kilimnik/lichtstab/pcb/Lichtstab.kicad_pcb

## KiCad design pcb/Lichtstab.kicad_pcb (2024-06-26)

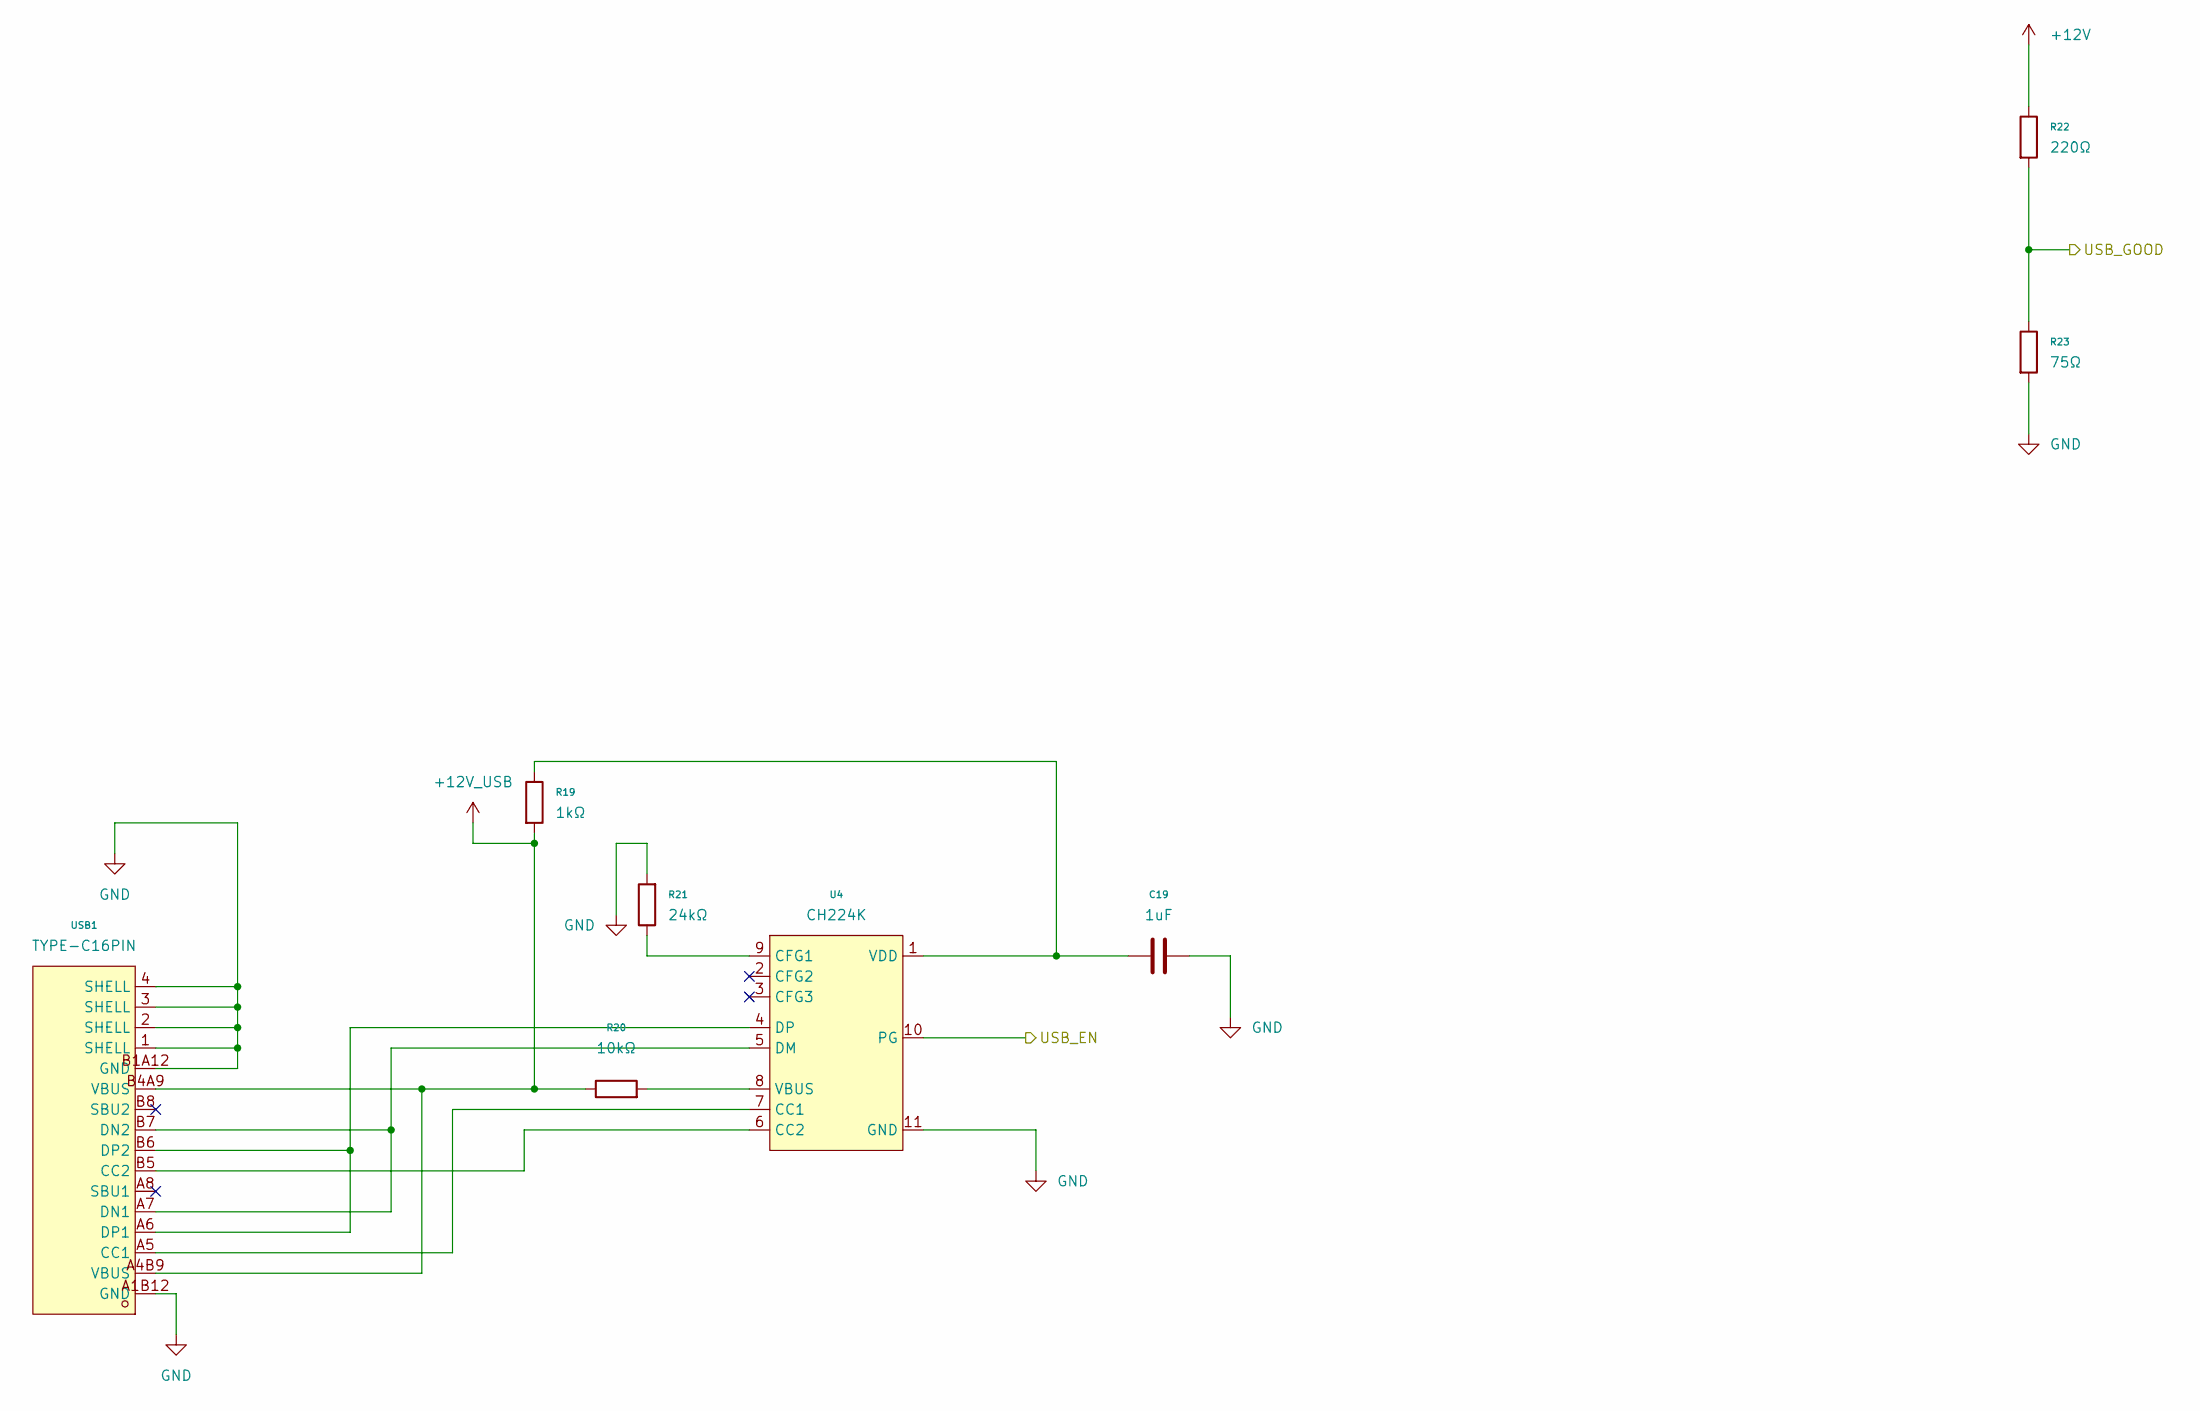
[picture p1: schematic 3_USB-PD.kicad_sch]

Parts:
C19: 1uF; C_0805_2012Metric; LCSC C28323
R19: 1kΩ; R_0603_1608Metric; LCSC C21190
R20: 10kΩ; R_0603_1608Metric; LCSC C25804
R21: 24kΩ; R_0603_1608Metric; LCSC C23352
R22: 220Ω; R_0603_1608Metric; LCSC C22962
R23: 75Ω; R_0603_1608Metric; LCSC C4275
U4: CH224K; ESSOP-10_L4.9-W3.9-P1.0-LS6.0-TL-EP; LCSC C970725
USB1: TYPE-C16PIN; USB-C-SMD_TYPE-C16PIN; LCSC C393939

Connections:
+12V: R22.1; also elsewhere on the board
+12V_USB: R19.2, R20.1, USB1.A4B9 (VBUS), USB1.B4A9 (VBUS); also elsewhere on the board
/General/ESP_EN: U4.10 (PG); also elsewhere on the board
/General/USB_GOOD: R22.2, R23.1; also elsewhere on the board
GND: C19.1, R21.2, R23.2, U4.11 (GND), USB1.1 (SHELL), USB1.2 (SHELL), USB1.3 (SHELL), USB1.4 (SHELL), USB1.A1B12 (GND), USB1.B1A12 (GND); also elsewhere on the board
unnamed: U4.7 (CC1), USB1.A5 (CC1)
unnamed: U4.6 (CC2), USB1.B5 (CC2)
unnamed: R21.1, U4.9 (CFG1)
unnamed: U4.5 (DM), USB1.A7 (DN1), USB1.B7 (DN2)
unnamed: U4.4 (DP), USB1.A6 (DP1), USB1.B6 (DP2)
unnamed: R20.2, U4.8 (VBUS)
unnamed: C19.2, R19.1, U4.1 (VDD)

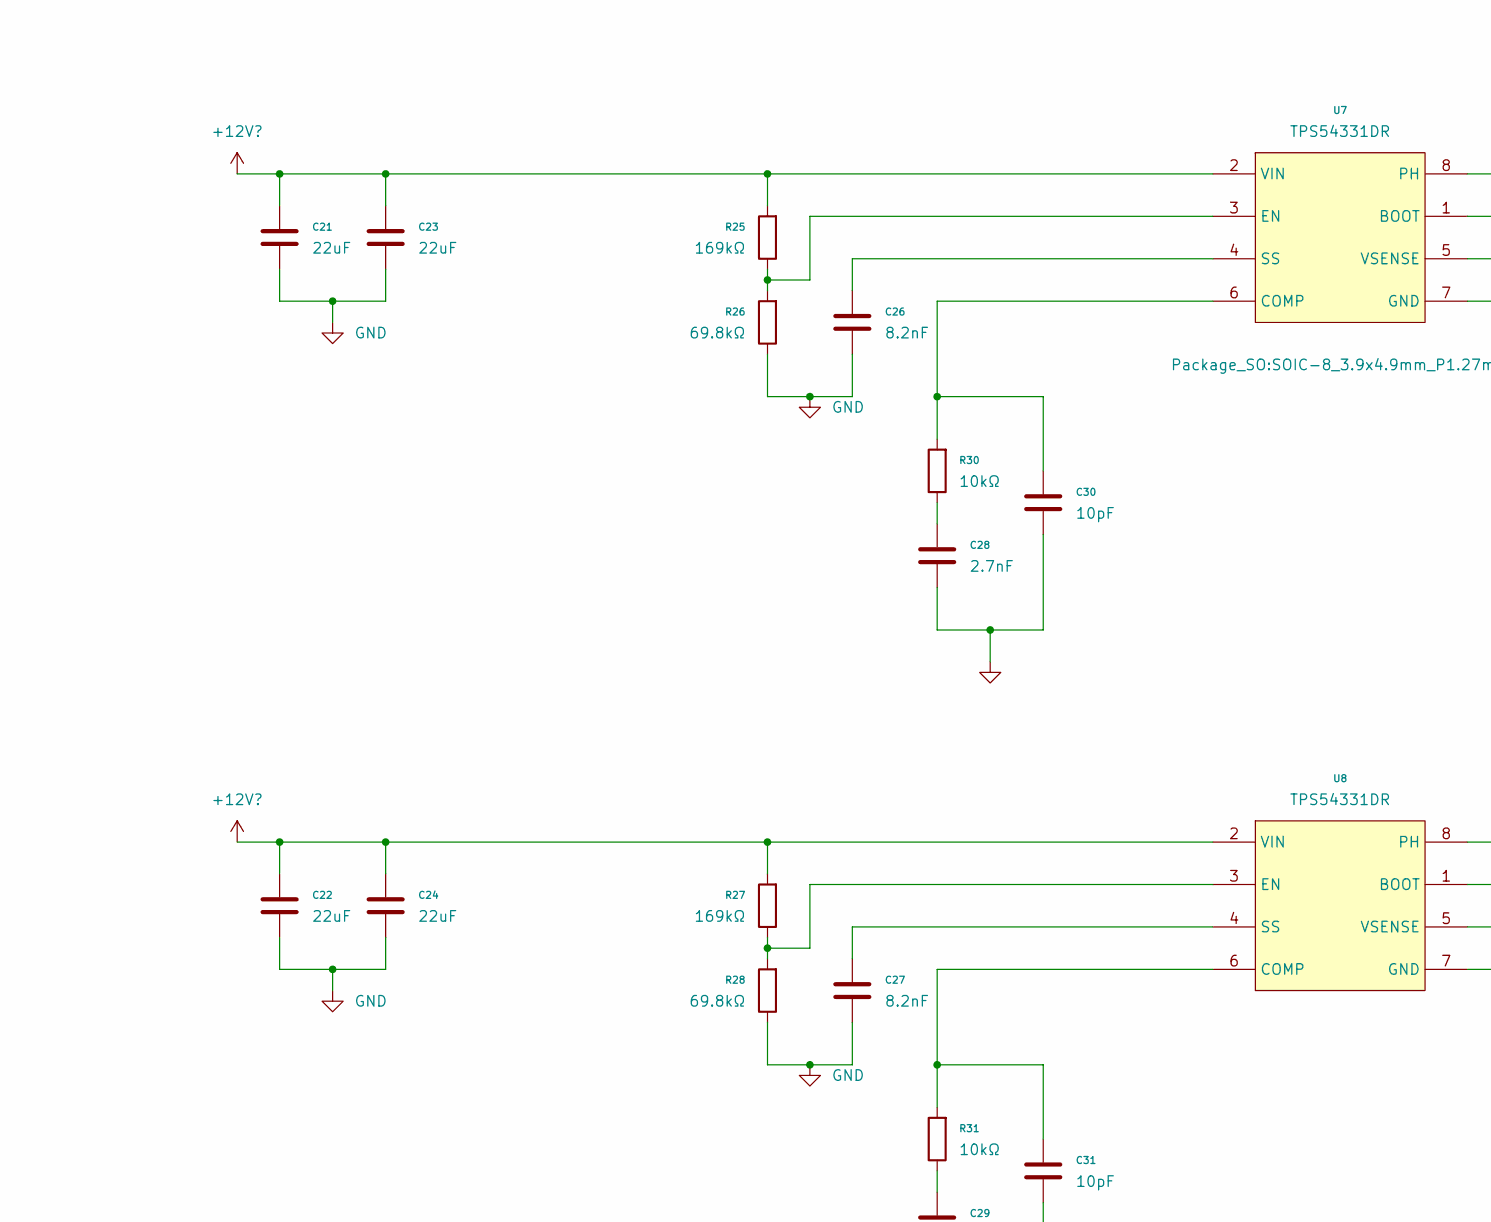
[picture p2: schematic 4_POWER.kicad_sch, part in row 1, column 1]

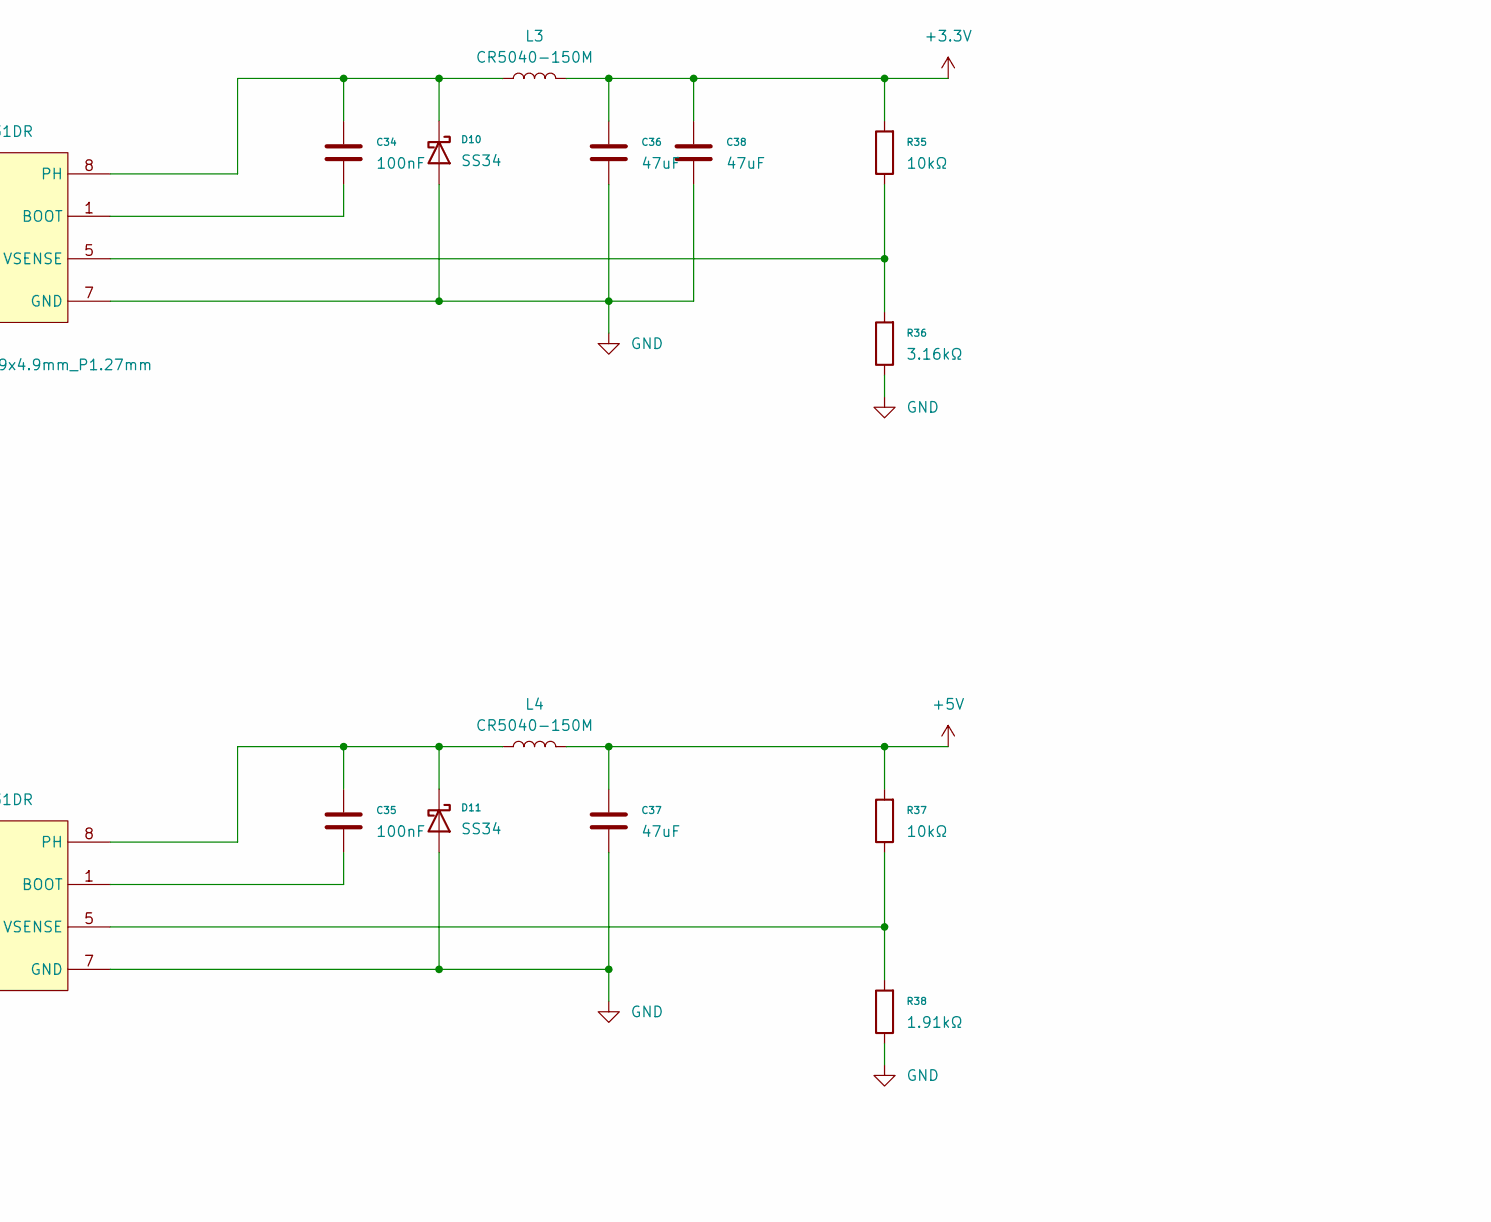
[picture p3: schematic 4_POWER.kicad_sch, part in row 1, column 2]

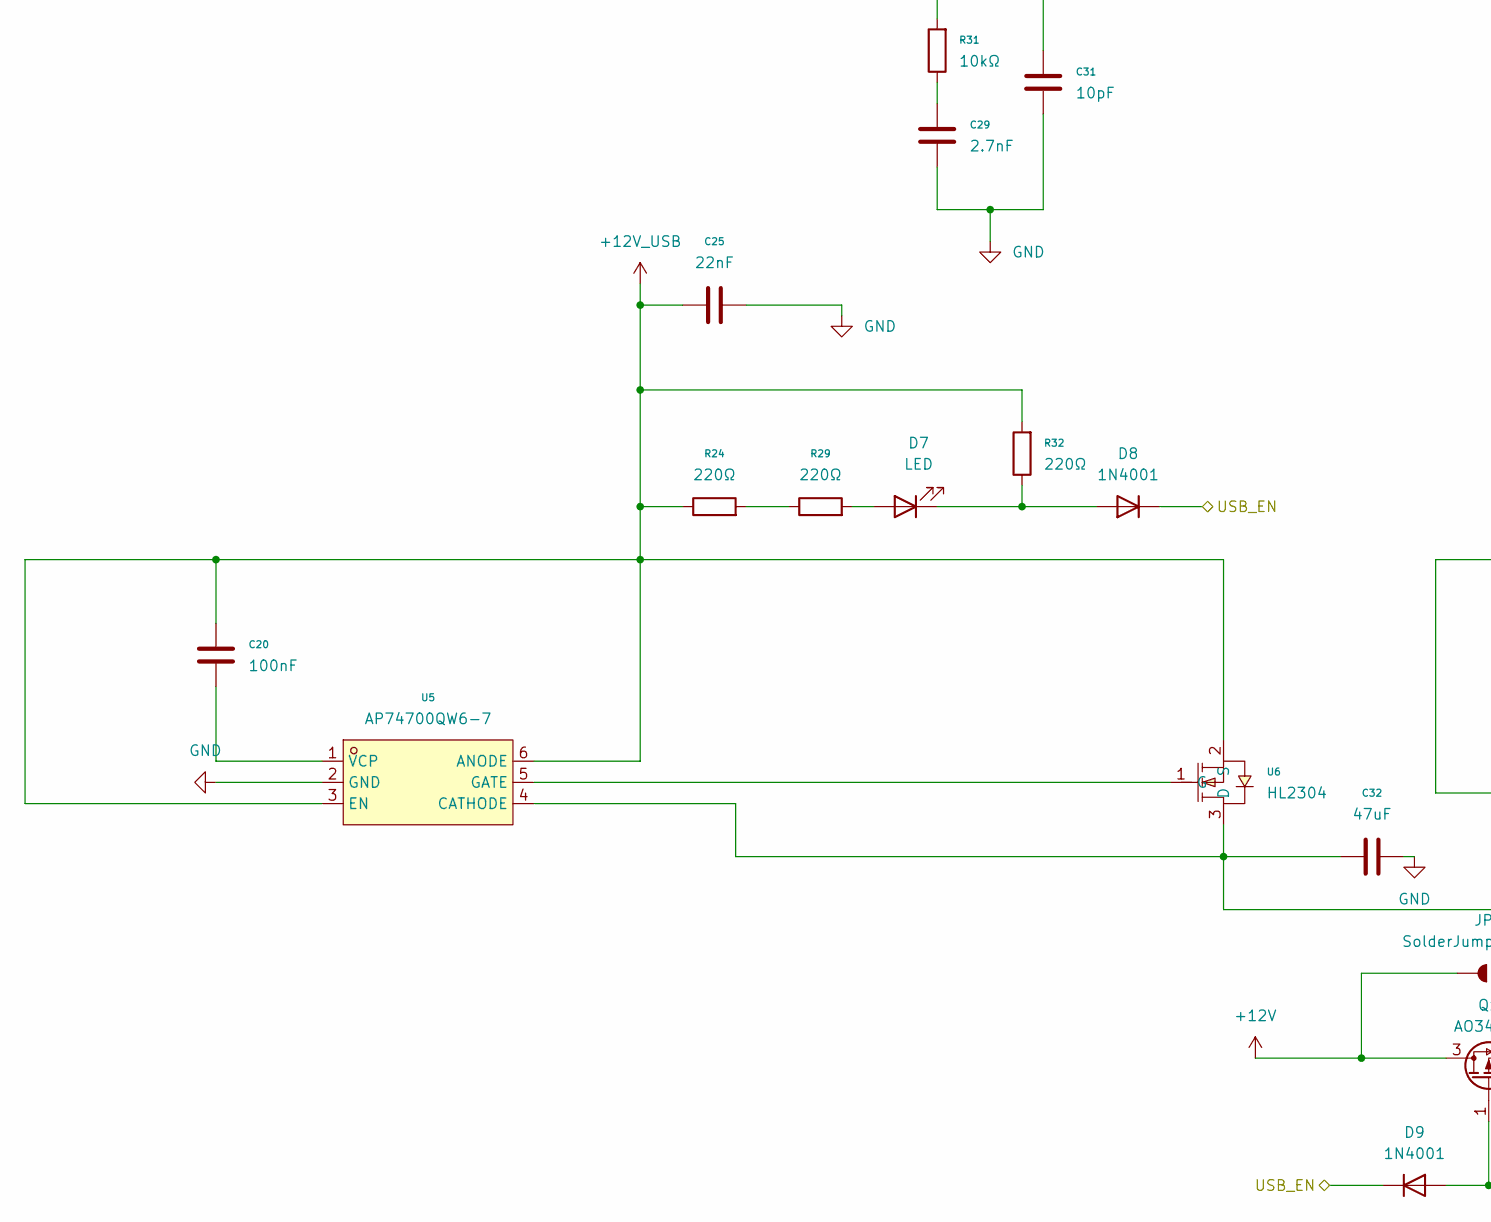
[picture p4: schematic 4_POWER.kicad_sch, part in row 2, column 1]

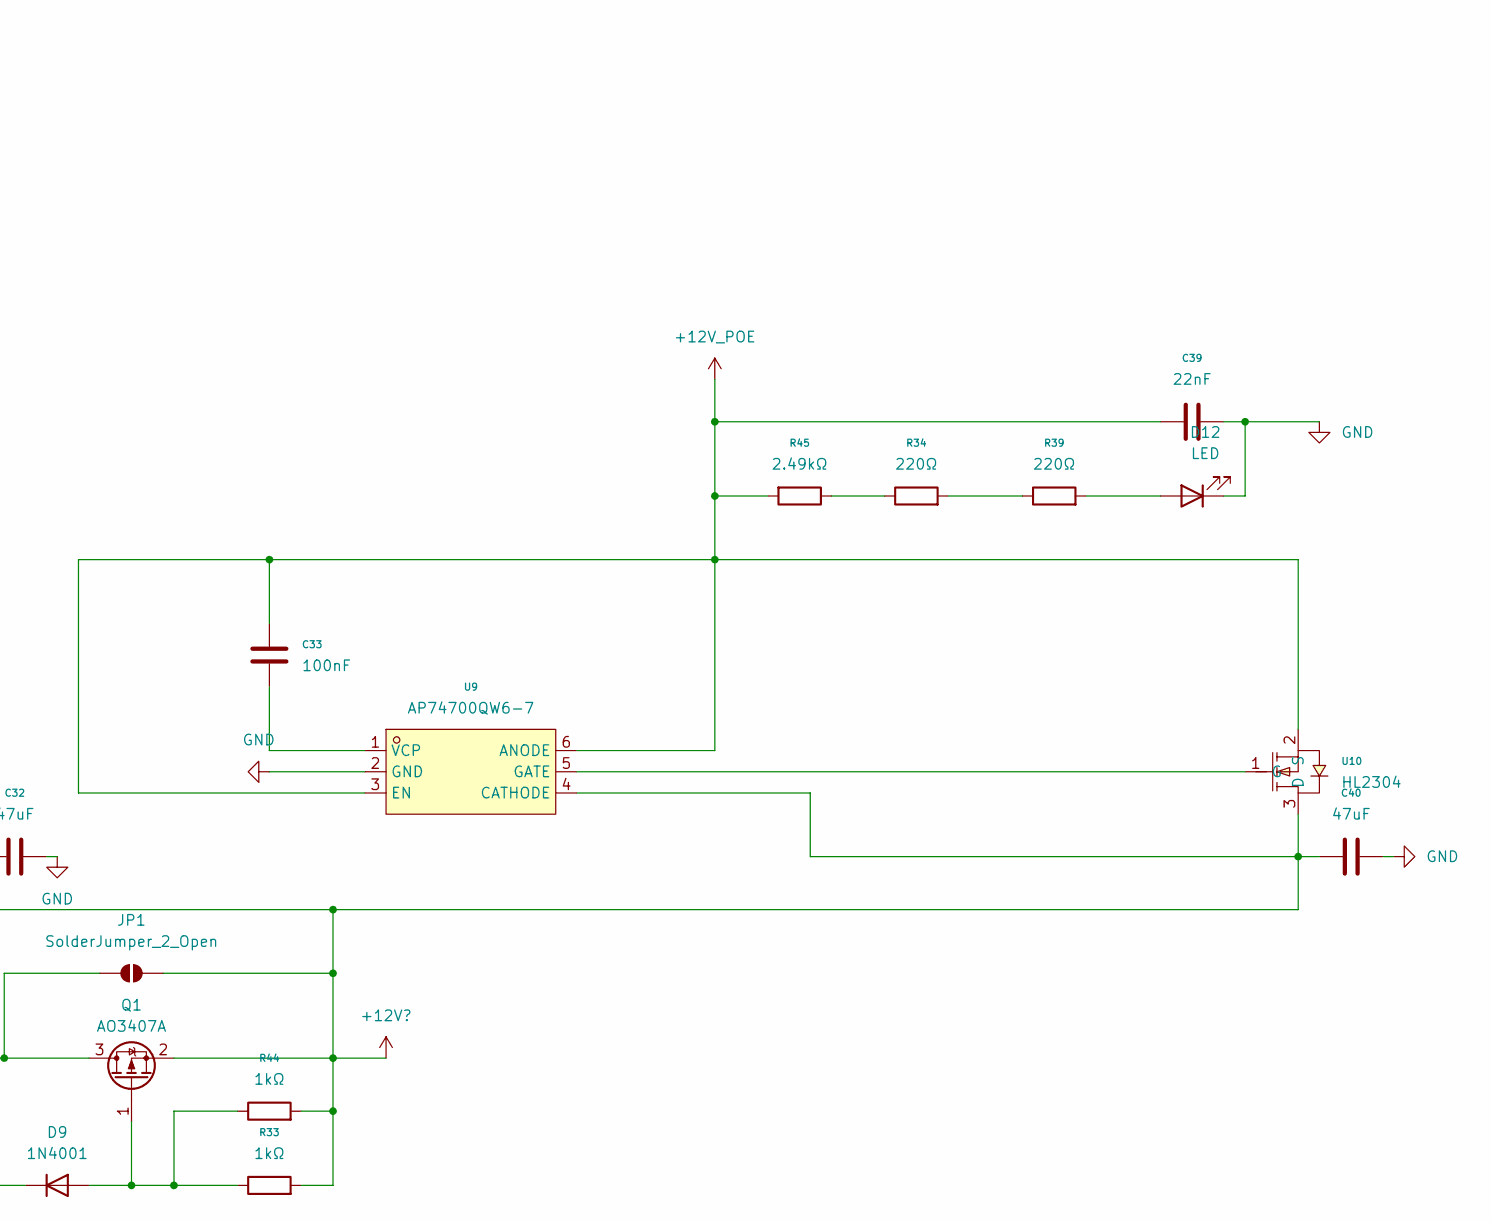
[picture p5: schematic 4_POWER.kicad_sch, part in row 2, column 2]

Parts:
C20, C33, C34, C35: 100nF; C_0603_1608Metric; LCSC C14663
C21, C22, C23, C24: 22uF; C_1210_3225Metric; LCSC C2918506
C25, C39: 22nF; C_0603_1608Metric; LCSC C21122
C26, C27: 8.2nF; C_0603_1608Metric; LCSC C1322360
C28, C29: 2.7nF; C_0805_2012Metric; LCSC C5186791
C30, C31: 10pF; C_0805_2012Metric; LCSC C157608
C32, C36, C37, C38, C40: 47uF; C_1206_3216Metric; LCSC C22367835
D7, D12: LED; LED_0805_2012Metric; LCSC C2297
D8, D9: 1N4001; D_SOD-123F; LCSC C2892326
D10, D11: SS34; D_SMA; LCSC C8678
JP1: SolderJumper_2_Open; SolderJumper-2_P1.3mm_Open_TrianglePad1.0x1.5mm
L3, L4: CR5040-150M; IND-SMD_L5.0-W5.0_SWPA5040S; LCSC Part C520353
Q1: AO3407A; SOT-23; LCSC C347478
R24, R29, R32, R34, R39: 220Ω; R_0603_1608Metric; LCSC C22962
R25, R27: 169kΩ; R_0603_1608Metric; LCSC C22817
R26, R28: 69.8kΩ; R_0603_1608Metric; LCSC C23098
R30, R31, R35, R37: 10kΩ; R_0603_1608Metric; LCSC C25804
R33, R44: 1kΩ; R_0603_1608Metric; LCSC C21190
R36: 3.16kΩ; R_0603_1608Metric; LCSC C22993
R38: 1.91kΩ; R_0603_1608Metric; LCSC C22853
R45: 2.49kΩ; R_0603_1608Metric; LCSC C22908
U5, U9: AP74700QW6-7; SOT-23-6; LCSC C5381661
U6, U10: HL2304; SOT-23; LCSC C7420346
U7, U8: TPS54331DR; SOIC-8_3.9x4.9mm_P1.27mm; LCSC C9865

Connections:
+3.3V: C36.1, C38.1, L3.2, R35.2; also elsewhere on the board
+5V: C37.2, L4.2, R37.2; also elsewhere on the board
+12V: JP1.1 (A), Q1.3 (D); also elsewhere on the board
+12V?: C21.2, C22.2, C23.2, C24.2, C32.1, C40.1, JP1.2 (B), Q1.2 (S), R25.2, R27.2, R33.2, R44.2, U5.4 (CATHODE), U6.3 (D), U7.2 (VIN), U8.2 (VIN), U9.4 (CATHODE), U10.3 (D)
+12V_POE: C33.1, C39.1, R45.2, U9.3 (EN), U9.6 (ANODE), U10.2 (S); also elsewhere on the board
+12V_USB: C20.1, C25.1, R24.1, R32.2, U5.3 (EN), U5.6 (ANODE), U6.2 (S); also elsewhere on the board
/General/ESP_EN: D8.1 (K), D9.1 (K); also elsewhere on the board
GND: C21.1, C22.1, C23.1, C24.1, C25.2, C26.1, C27.1, C28.1, C29.1, C30.1, C31.1, C32.2, C36.2, C37.1, C38.2, C39.2, C40.2, D10.2 (A), D11.2 (A), D12.1 (K), R26.1, R28.1, R36.1, R38.1, U5.2 (GND), U7.7 (GND), U8.7 (GND), U9.2 (GND); also elsewhere on the board
unnamed: C28.2, R30.1
unnamed: C29.2, R31.1
unnamed: D7.2 (A), R29.2
unnamed: D7.1 (K), D8.2 (A), R32.1
unnamed: D9.2 (A), Q1.1 (G), R33.1, R44.1
unnamed: C34.1, D10.1 (K), L3.1, U7.8 (PH)
unnamed: C35.1, D11.1 (K), L4.1, U8.8 (PH)
unnamed: D12.2 (A), R39.2
unnamed: R24.2, R29.1
unnamed: R34.1, R45.1
unnamed: R34.2, R39.1
unnamed: U5.5 (GATE), U6.1 (G)
unnamed: C20.2, U5.1 (VCP)
unnamed: C34.2, U7.1 (BOOT)
unnamed: C30.2, R30.2, U7.6 (COMP)
unnamed: R25.1, R26.2, U7.3 (EN)
unnamed: C26.2, U7.4 (SS)
unnamed: R35.1, R36.2, U7.5 (VSENSE)
unnamed: C35.2, U8.1 (BOOT)
unnamed: C31.2, R31.2, U8.6 (COMP)
unnamed: R27.1, R28.2, U8.3 (EN)
unnamed: C27.2, U8.4 (SS)
unnamed: R37.1, R38.2, U8.5 (VSENSE)
unnamed: C33.2, U9.1 (VCP)
unnamed: U9.5 (GATE), U10.1 (G)

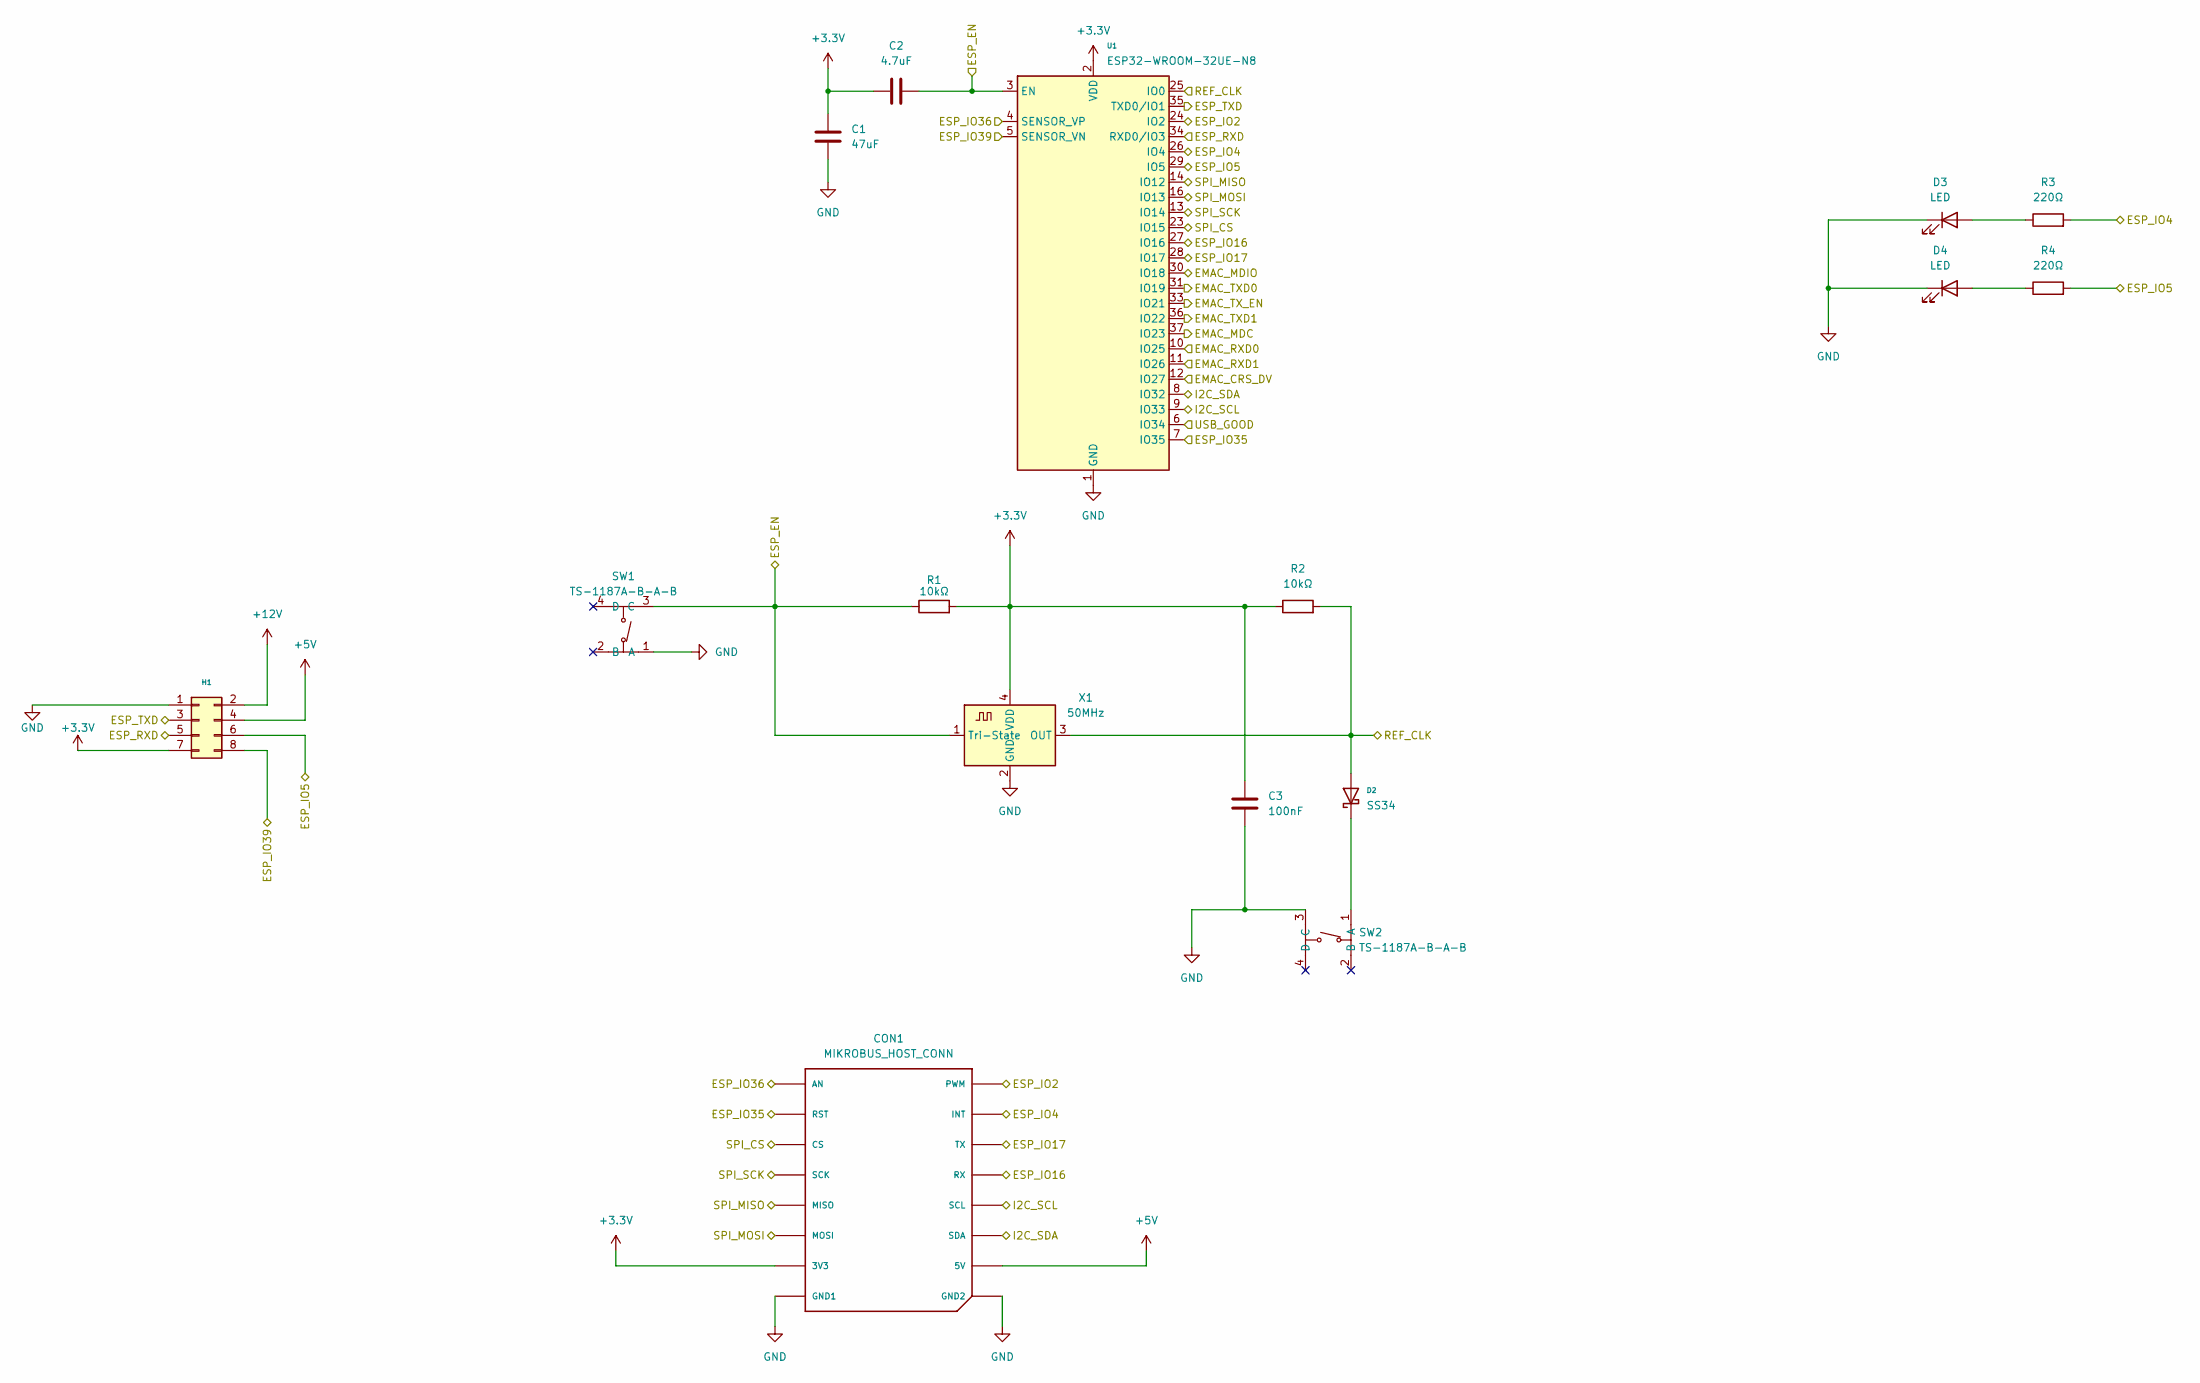
[picture p6: schematic 1_P1.kicad_sch]

Parts:
C1: 47uF; C_1206_3216Metric; LCSC C22367835
C2: 4.7uF; C_0603_1608Metric
C3: 100nF; C_0603_1608Metric
CON1: MIKROBUS_HOST_CONN
D2: SS34; D_SMA; LCSC C8678
D3, D4: LED; LED_0805_2012Metric; LCSC C34499
H1: PinHeader_2x04_P2.54mm_Vertical_SMD; Manufacturer Part Programming Header; LCSC C192300
R1, R2: 10kΩ; R_0603_1608Metric
R3, R4: 220Ω; R_0603_1608Metric
SW1: TS-1187A-B-A-B; SW-SMD_4P-L5.1-W5.1-P3.70-LS6.5-TL-2; Manufacturer Part Reset Switch; LCSC C318884
SW2: TS-1187A-B-A-B; SW-SMD_4P-L5.1-W5.1-P3.70-LS6.5-TL-2; Manufacturer Part Boot Switch; LCSC C318884
U1: ESP32-WROOM-32UE-N8; ESP32-WROOM-32UE; LCSC C701345
X1: 50MHz; Crystal_SMD_3225-4Pin_3.2x2.5mm; LCSC C717684

Connections:
+3.3V: C1.1, C2.2, C3.1, CON1.P7 (3V3), H1.7, R1.2, R2.1, U1.2 (VDD), X1.4 (VDD); also elsewhere on the board
+5V: CON1.P10 (5V), H1.4; also elsewhere on the board
+12V: H1.2; also elsewhere on the board
/General/EMAC_CRS_DV: U1.12 (IO27); also elsewhere on the board
/General/EMAC_MDC: U1.37 (IO23); also elsewhere on the board
/General/EMAC_MDIO: U1.30 (IO18); also elsewhere on the board
/General/EMAC_RXD0: U1.10 (IO25); also elsewhere on the board
/General/EMAC_RXD1: U1.11 (IO26); also elsewhere on the board
/General/EMAC_TXD0: U1.31 (IO19); also elsewhere on the board
/General/EMAC_TXD1: U1.36 (IO22); also elsewhere on the board
/General/EMAC_TX_EN: U1.33 (IO21); also elsewhere on the board
/General/ESP_EN: C2.1, R1.1, SW1.3 (C), U1.3 (EN), X1.1 (Tri-State); also elsewhere on the board
/General/ESP_IO2: CON1.P16 (PWM), U1.24 (IO2); also elsewhere on the board
/General/ESP_IO4: CON1.P15 (INT), R3.2, U1.26 (IO4); also elsewhere on the board
/General/ESP_IO5: H1.6, R4.2, U1.29 (IO5); also elsewhere on the board
/General/ESP_IO16: CON1.P13 (RX), U1.27 (IO16); also elsewhere on the board
/General/ESP_IO17: CON1.P14 (TX), U1.28 (IO17); also elsewhere on the board
/General/ESP_IO35: CON1.P2 (RST), U1.7 (IO35); also elsewhere on the board
/General/ESP_IO36: CON1.P1 (AN), U1.4 (SENSOR_VP); also elsewhere on the board
/General/ESP_IO39: H1.8, U1.5 (SENSOR_VN); also elsewhere on the board
/General/ESP_RXD: H1.5, U1.34 (RXD0/IO3)
/General/ESP_TXD: H1.3, U1.35 (TXD0/IO1)
/General/I2C_SCL: CON1.P12 (SCL), U1.9 (IO33); also elsewhere on the board
/General/I2C_SDA: CON1.P11 (SDA), U1.8 (IO32); also elsewhere on the board
/General/REF_CLK: D2.2 (A), R2.2, U1.25 (IO0), X1.3 (OUT); also elsewhere on the board
/General/SPI_CS: CON1.P3 (CS), U1.23 (IO15); also elsewhere on the board
/General/SPI_MISO: CON1.P5 (MISO), U1.14 (IO12); also elsewhere on the board
/General/SPI_MOSI: CON1.P6 (MOSI), U1.16 (IO13); also elsewhere on the board
/General/SPI_SCK: CON1.P4 (SCK), U1.13 (IO14); also elsewhere on the board
/General/USB_GOOD: U1.6 (IO34); also elsewhere on the board
GND: C1.2, C3.2, CON1.P8 (GND1), CON1.P9 (GND2), D3.1 (K), D4.1 (K), H1.1, SW1.1 (A), SW2.3 (C), U1.1 (GND), U1.15 (GND), U1.38 (GND), U1.39 (GND), X1.2 (GND); also elsewhere on the board
unnamed: D2.1 (K), SW2.1 (A)
unnamed: D3.2 (A), R3.1
unnamed: D4.2 (A), R4.1

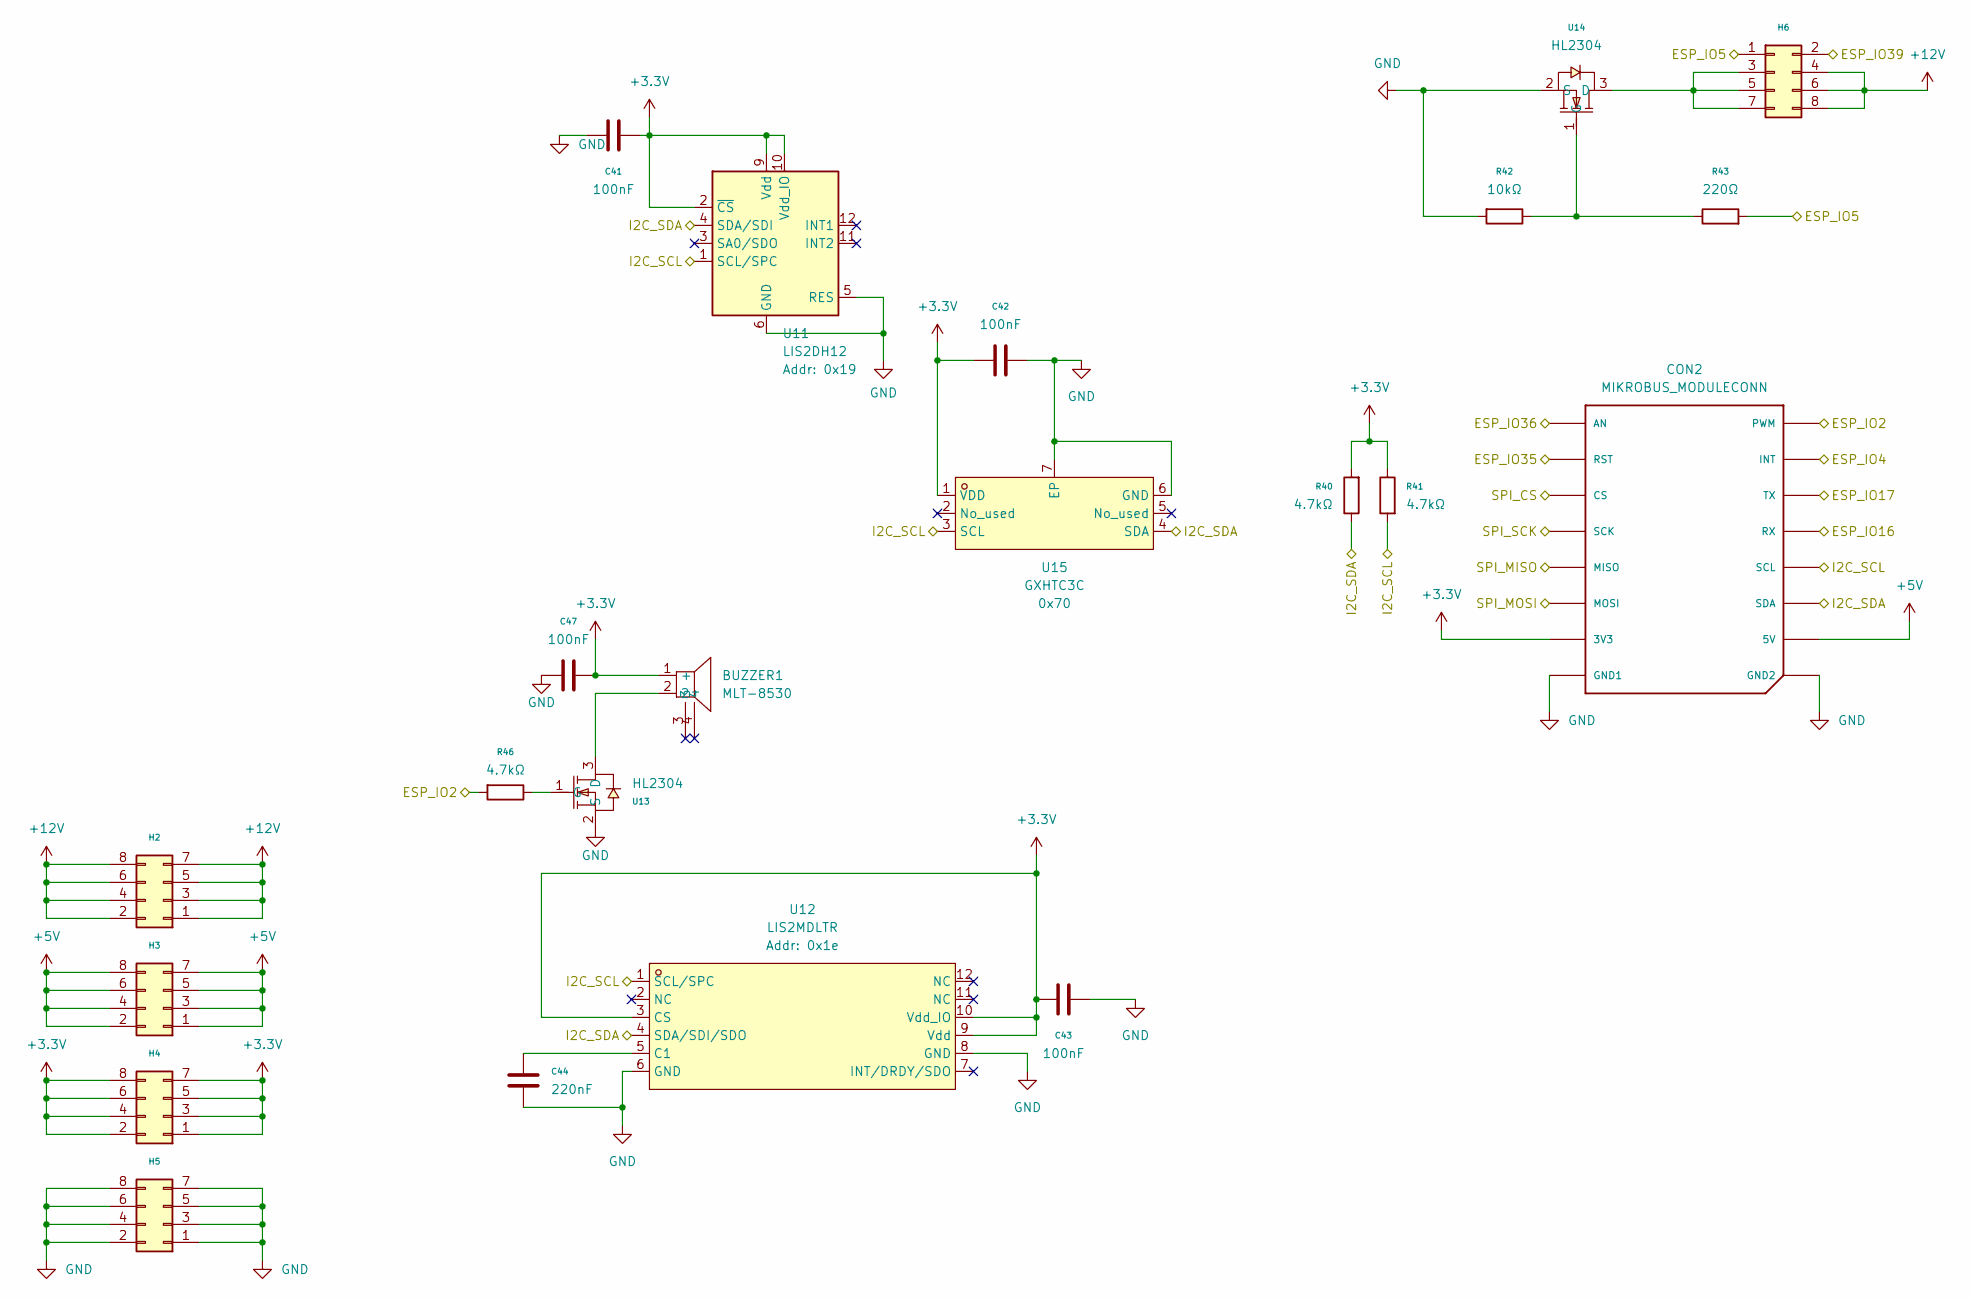
[picture p7: schematic sensors.kicad_sch]

Parts:
BUZZER1: MLT-8530; BUZ-SMD_4P-L8.5-W8.5-P8.50-BR; LCSC Part C94599
C41, C42, C43, C47: 100nF; C_0603_1608Metric; LCSC C14663
C44: 220nF; C_0603_1608Metric
CON2: MIKROBUS_MODULECONN; MIKROBUS_MODULE_CONN
H2: 2.54-2*4P立贴针; PinHeader_2x04_P2.54mm_Vertical_SMD; Manufacturer Part 12V Header; LCSC C192300
H3, H4: 2.54-2*4P立贴针; PinHeader_2x04_P2.54mm_Vertical_SMD; Manufacturer Part 3.3V Header; LCSC C192300
H5: 2.54-2*4P立贴针; PinHeader_2x04_P2.54mm_Vertical_SMD; Manufacturer Part GND Header; LCSC C192300
H6: 2.54-2*4P立贴针; PinHeader_2x04_P2.54mm_Vertical_SMD; Manufacturer Part Light Header; LCSC C192300
R40, R41, R46: 4.7kΩ; R_0603_1608Metric; LCSC C23162
R42: 10kΩ; R_0603_1608Metric; LCSC C25804
R43: 220Ω; R_0603_1608Metric; LCSC C22962
U11: LIS2DH12; LGA-12_2x2mm_P0.5mm; LCSC C110926
U12: LIS2MDLTR; LGA-12_L2.0-W2.0-P0.50-BL; LCSC C919695
U13, U14: HL2304; SOT-23; LCSC C7420346
U15: GXHTC3C; DFN-6_L2.0-W2.0-P0.50-TL-EP; LCSC Part C2913568

Connections:
+3.3V: BUZZER1.1 (+), C41.1, C42.2, C43.1, C47.1, CON2.P7 (3V3), H4.1, H4.2, H4.3, H4.4, H4.5, H4.6, H4.7, H4.8, R40.2, R41.1, U11.2 (~CS), U11.9 (Vdd), U11.10 (Vdd_IO), U12.3 (CS), U12.9 (Vdd), U12.10 (Vdd_IO), U15.1 (VDD); also elsewhere on the board
+5V: CON2.P10 (5V), H3.1, H3.2, H3.3, H3.4, H3.5, H3.6, H3.7, H3.8; also elsewhere on the board
+12V: H2.1, H2.2, H2.3, H2.4, H2.5, H2.6, H2.7, H2.8, H6.4, H6.6, H6.8; also elsewhere on the board
/General/ESP_IO2: CON2.P16 (PWM), R46.2; also elsewhere on the board
/General/ESP_IO4: CON2.P15 (INT); also elsewhere on the board
/General/ESP_IO5: H6.1, R43.2; also elsewhere on the board
/General/ESP_IO16: CON2.P13 (RX); also elsewhere on the board
/General/ESP_IO17: CON2.P14 (TX); also elsewhere on the board
/General/ESP_IO35: CON2.P2 (RST); also elsewhere on the board
/General/ESP_IO36: CON2.P1 (AN); also elsewhere on the board
/General/ESP_IO39: H6.2; also elsewhere on the board
/General/I2C_SCL: CON2.P12 (SCL), R41.2, U11.1 (SCL/SPC), U12.1 (SCL/SPC), U15.3 (SCL); also elsewhere on the board
/General/I2C_SDA: CON2.P11 (SDA), R40.1, U11.4 (SDA/SDI), U12.4 (SDA/SDI/SDO), U15.4 (SDA); also elsewhere on the board
/General/SPI_CS: CON2.P3 (CS); also elsewhere on the board
/General/SPI_MISO: CON2.P5 (MISO); also elsewhere on the board
/General/SPI_MOSI: CON2.P6 (MOSI); also elsewhere on the board
/General/SPI_SCK: CON2.P4 (SCK); also elsewhere on the board
GND: C41.2, C42.1, C43.2, C44.1, C47.2, CON2.P8 (GND1), CON2.P9 (GND2), H5.1, H5.2, H5.3, H5.4, H5.5, H5.6, H5.7, H5.8, R42.2, U11.5 (RES), U11.6 (GND), U11.7 (GND), U11.8 (GND), U12.6 (GND), U12.8 (GND), U13.2 (S), U14.2 (S), U15.6 (GND), U15.7 (EP); also elsewhere on the board
unnamed: H6.3, H6.5, H6.7, U14.3 (D)
unnamed: C44.2, U12.5 (C1)
unnamed: BUZZER1.2, U13.3 (D)
unnamed: R46.1, U13.1 (G)
unnamed: R42.1, R43.1, U14.1 (G)
