kilimnik/lichtstab/pcb/Lichtstab.kicad_pcb

## KiCad design pcb/Lichtstab.kicad_pcb (continued)

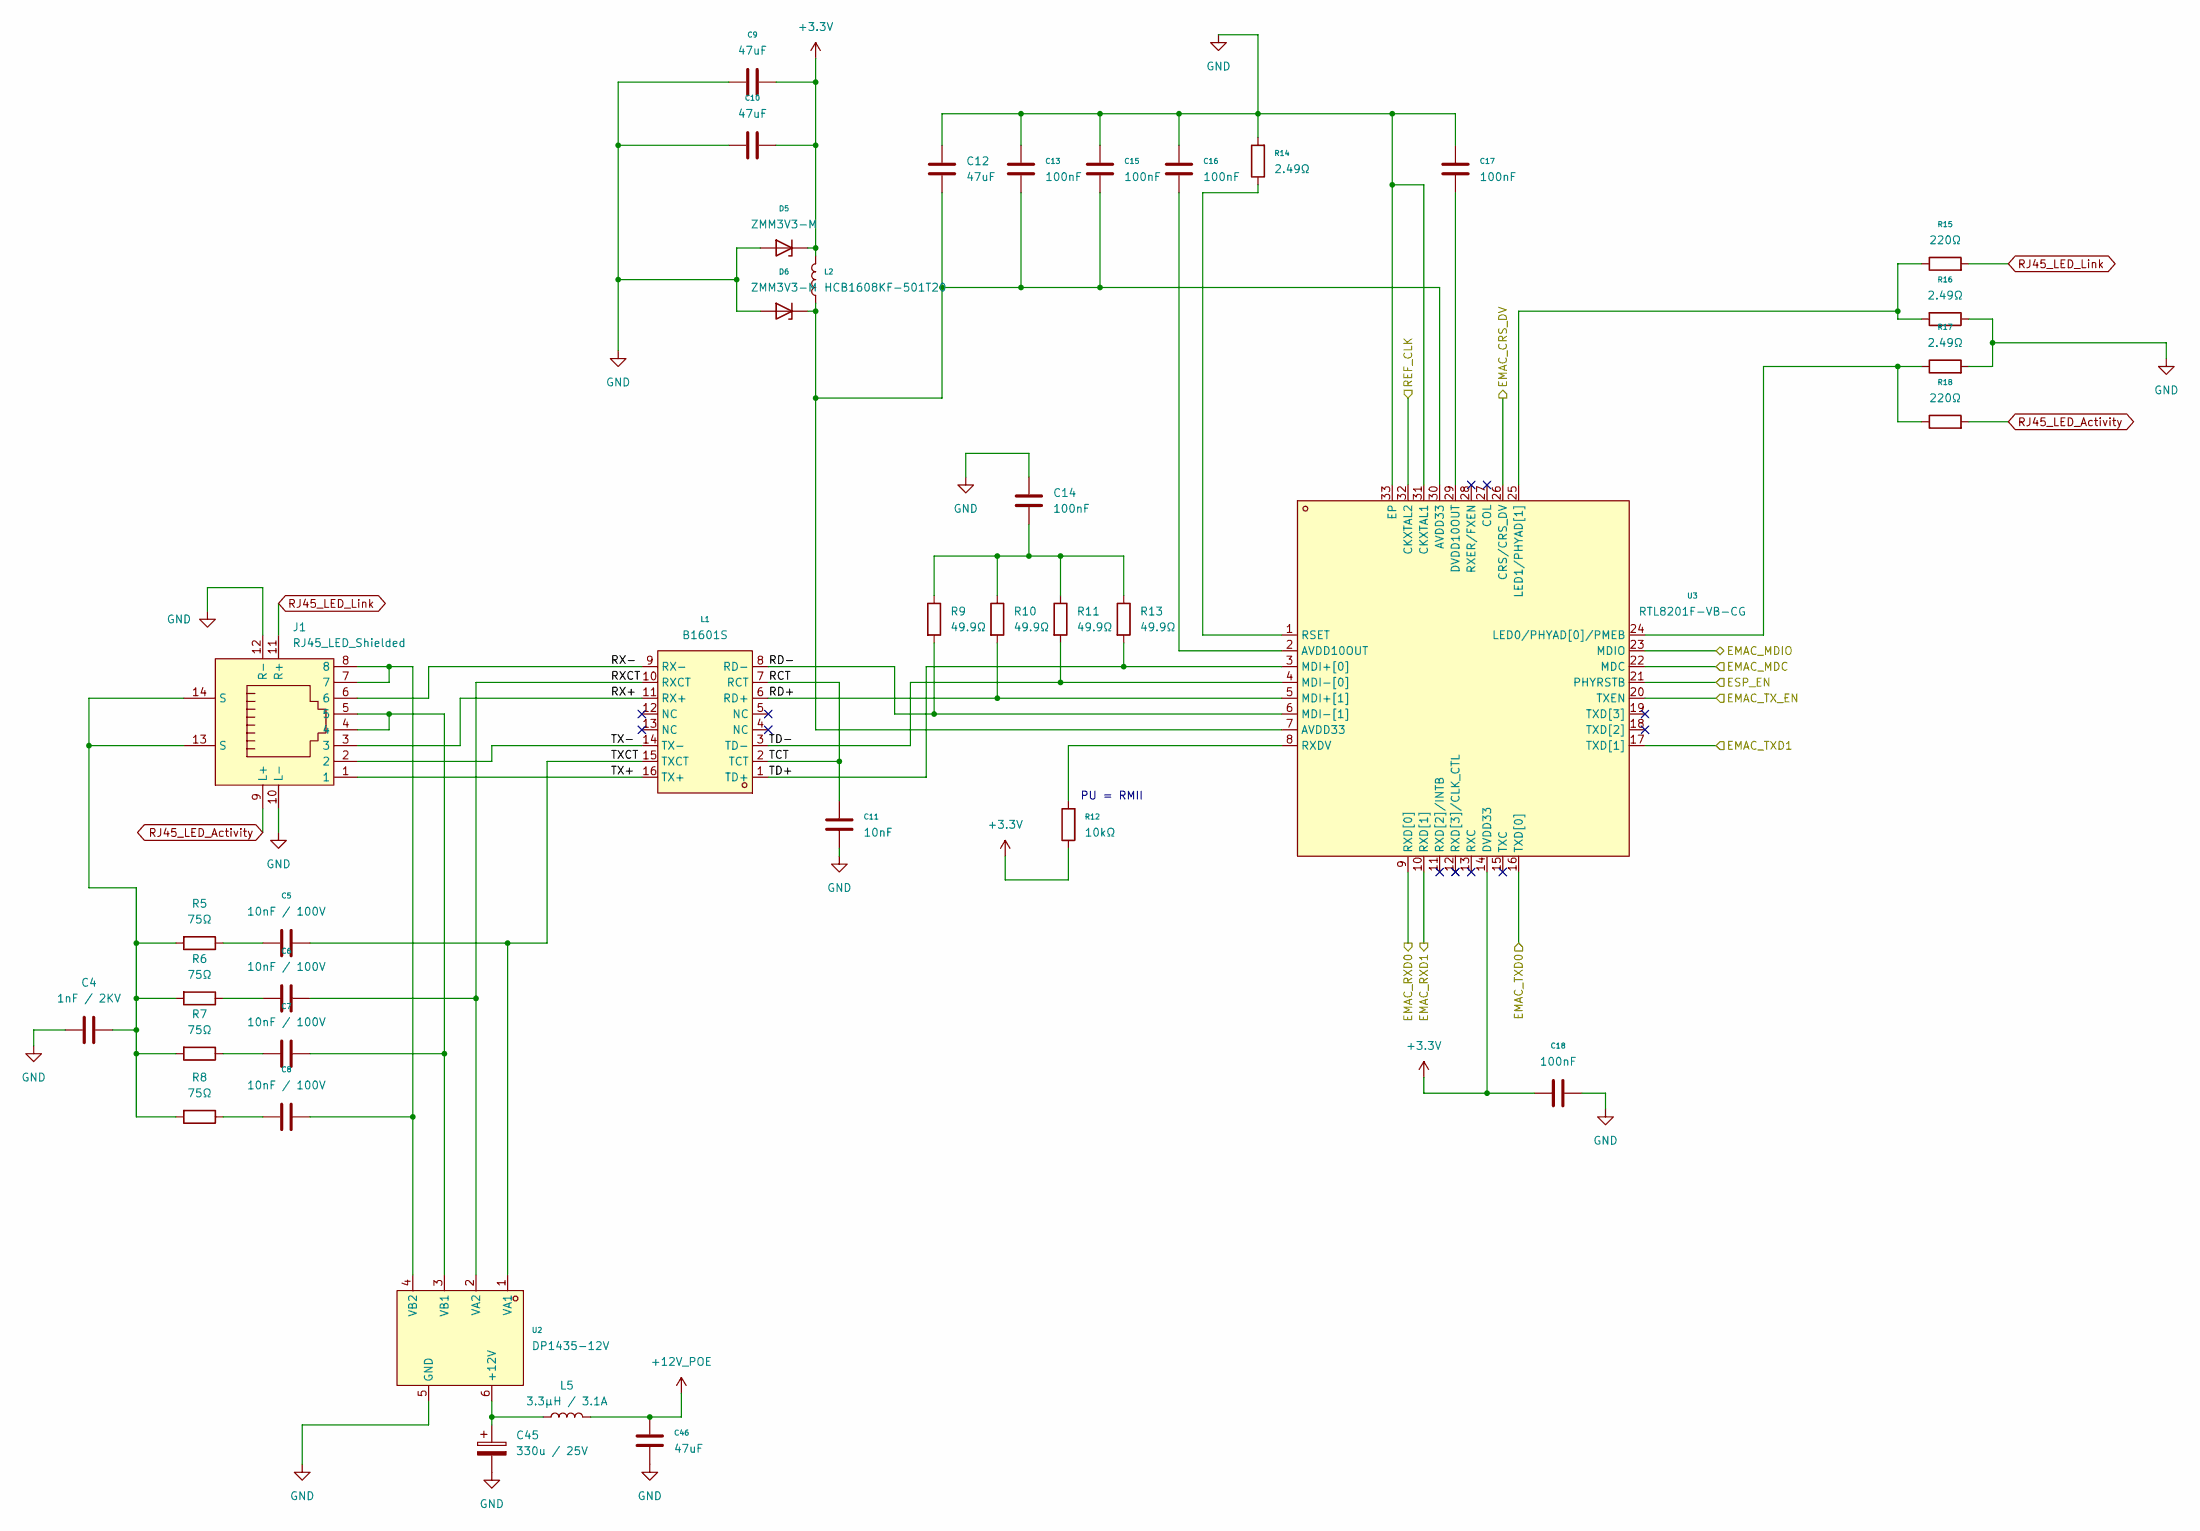
[picture p8: schematic 2_POE.kicad_sch]

Parts:
C4: 1nF / 2KV; C_1206_3216Metric
C5, C6, C7, C8: 10nF / 100V; C_0603_1608Metric; LCSC C43253
C9, C10, C12, C46: 47uF; C_1206_3216Metric; LCSC C22367835
C11: 10nF; C_0603_1608Metric; LCSC C43253
C13, C15, C16, C17, C18: 100nF; C_0603_1608Metric; LCSC C14663
C14: 100nF; C_0603_1608Metric
C45: 330u / 25V; CP_Elec_8x10.5; LCSC C335985
D5, D6: ZMM3V3-M; D_MiniMELF; LCSC C2891740
J1: RJ45_LED_Shielded; RJ45-TH_R-RJ45R08P-C000; LCSC Part C386757
L1: B1601S; SMD-16_L12.7-W7.0-P1.27-LS9.5-BL; LCSC C510548
L2: HCB1608KF-501T20; L_0603_1608Metric; LCSC C356977
L5: 3.3µH / 3.1A; L_Changjiang_FNR5030S; LCSC C2847470
R5, R6, R7, R8: 75Ω; R_0603_1608Metric; LCSC C4275
R9, R10, R11, R13: 49.9Ω; R_0402_1005Metric
R12: 10kΩ; R_0603_1608Metric; LCSC C25804
R14, R16, R17: 2.49Ω; R_0603_1608Metric; LCSC C22908
R15, R18: 220Ω; R_0603_1608Metric; LCSC C22962
U2: DP1435-12V; PWRM-TH_DP1435-XX; LCSC Part C5380098
U3: RTL8201F-VB-CG; TQFN-32-1EP_5x5mm_P0.5mm_EP3.4x3.4mm_ThermalVias; LCSC C45044

Connections:
+3.3V: C9.1, C10.1, C18.1, D5.1 (K), L2.2, R12.1, U3.14 (DVDD33); also elsewhere on the board
+12V_POE: C46.2, L5.2; also elsewhere on the board
/General/EMAC_CRS_DV: U3.26 (CRS/CRS_DV); also elsewhere on the board
/General/EMAC_MDC: U3.22 (MDC); also elsewhere on the board
/General/EMAC_MDIO: U3.23 (MDIO); also elsewhere on the board
/General/EMAC_RXD0: U3.9 (RXD[0]); also elsewhere on the board
/General/EMAC_RXD1: U3.10 (RXD[1]); also elsewhere on the board
/General/EMAC_TXD0: U3.16 (TXD[0]); also elsewhere on the board
/General/EMAC_TXD1: U3.17 (TXD[1]); also elsewhere on the board
/General/EMAC_TX_EN: U3.20 (TXEN); also elsewhere on the board
/General/ESP_EN: U3.21 (PHYRSTB); also elsewhere on the board
/General/REF_CLK: U3.32 (CKXTAL2); also elsewhere on the board
/POE/RCT: C11.2, L1.2 (TCT), L1.7 (RCT)
/POE/RD+: L1.6 (RD+), R10.2, U3.5 (MDI+[1])
/POE/RD-: L1.8 (RD-), R9.2, U3.6 (MDI-[1])
/POE/RX+: J1.3, L1.11 (RX+)
/POE/RX-: J1.6, L1.9 (RX-)
/POE/RXCT: C6.2, L1.10 (RXCT), U2.2 (VA2)
/POE/TD+: L1.1 (TD+), R13.2, U3.3 (MDI+[0])
/POE/TD-: L1.3 (TD-), R11.2, U3.4 (MDI-[0])
/POE/TX+: J1.1, L1.16 (TX+)
/POE/TX-: J1.2, L1.14 (TX-)
/POE/TXCT: C5.2, L1.15 (TXCT), U2.1 (VA1)
GND: C4.1, C9.2, C10.2, C11.1, C12.1, C13.1, C14.1, C15.1, C16.1, C17.1, C18.2, C45.2, C46.1, D5.2 (A), D6.2 (A), J1.10 (L-), J1.12 (R-), R14.2, R16.1, R17.2, U2.5 (GND), U3.31 (CKXTAL1), U3.33 (EP); also elsewhere on the board
unnamed: C4.2, J1.13 (S), J1.14 (S), R5.2, R6.2, R7.2, R8.2
unnamed: C5.1, R5.1
unnamed: C6.1, R6.1
unnamed: C7.1, R7.1
unnamed: C8.2, R8.1
unnamed: C14.2, R9.1, R10.1, R11.1, R13.1
unnamed: C12.2, C13.2, C15.2, D6.1 (K), L2.1, U3.7 (AVDD33), U3.30 (AVDD33)
unnamed: C45.1, L5.1, U2.6 (+12V)
unnamed: C7.2, J1.4, J1.5, U2.3 (VB1)
unnamed: C8.1, J1.7, J1.8, U2.4 (VB2)
unnamed: C16.2, U3.2 (AVDD10OUT)
unnamed: C17.2, U3.29 (DVDD10OUT)
unnamed: R17.1, R18.1, U3.24 (LED0/PHYAD[0]/PMEB)
unnamed: R15.1, R16.2, U3.25 (LED1/PHYAD[1])
unnamed: R14.1, U3.1 (RSET)
unnamed: R12.2, U3.8 (RXDV)
RJ45_LED_Activity: J1.9 (L+), R18.2
RJ45_LED_Link: J1.11 (R+), R15.2

Notes on the sheet:
PU = RMII

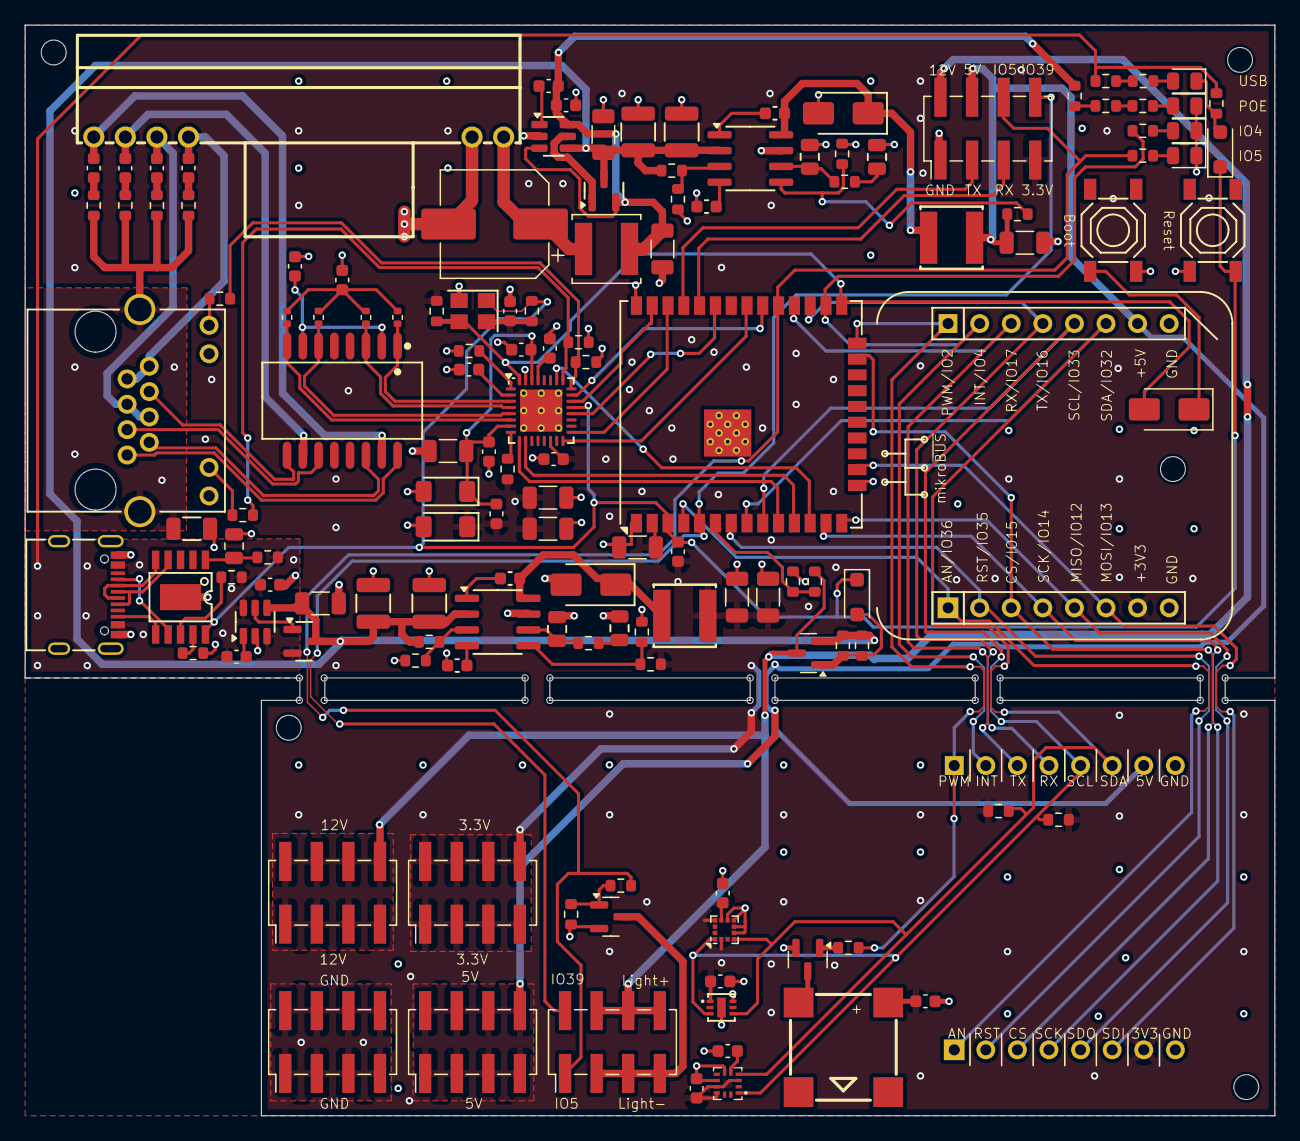
[picture p9: board Lichtstab.kicad_pcb from above]

Board: 4 copper layers, 100.5 x 87.7 mm, 140 parts (1 on the bottom side), 103 nets.
