kilimnik/lichtstab/(commit log)

2024-06-23 4 layer pcb
    [1_P1.kicad_sch, 4_POWER.kicad_sch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]
2024-06-23 add mounting holes
    [Lichtstab-CuBottom.gbr, Lichtstab-CuIn1.gbr, Lichtstab-CuIn2.gbr, Lichtstab-CuTop.gbr, Lichtstab-EdgeCuts.gbr, Lichtstab-MaskBottom.gbr, Lichtstab-MaskTop.gbr, Lichtstab-NPTH.drl]
2024-06-24 fix GXHTC3C pinout
    [Lichtstab-CuBottom.gbr, Lichtstab-CuIn1.gbr, Lichtstab-CuIn2.gbr, Lichtstab-CuTop.gbr, Lichtstab-EdgeCuts.gbr, Lichtstab-MaskBottom.gbr, Lichtstab-MaskTop.gbr, Lichtstab-NPTH.drl]
2024-06-25 fix 3D Models
    [Lichtstab.kicad_pcb]
2024-06-25 fix holes
    [Lichtstab-CuBottom.gbr, Lichtstab-CuIn1.gbr, Lichtstab-CuIn2.gbr, Lichtstab-CuTop.gbr, Lichtstab-EdgeCuts.gbr, Lichtstab-MaskBottom.gbr, Lichtstab-MaskTop.gbr, Lichtstab-NPTH.drl]
2024-06-26 review version
    [1_P1.kicad_sch, 2_POE.kicad_sch, 3_USB-PD.kicad_sch, 4_POWER.kicad_sch, Lichtstab.kicad_pcb, Lichtstab.kicad_sch, sensors.kicad_sch]
2024-06-26 remove third pcb and more flash
    [1_P1.kicad_sch, 2_POE.kicad_sch, 3_USB-PD.kicad_sch, 4_POWER.kicad_sch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]
